ajayre/djetecutester/InjectorStand/InjectorStand2.png

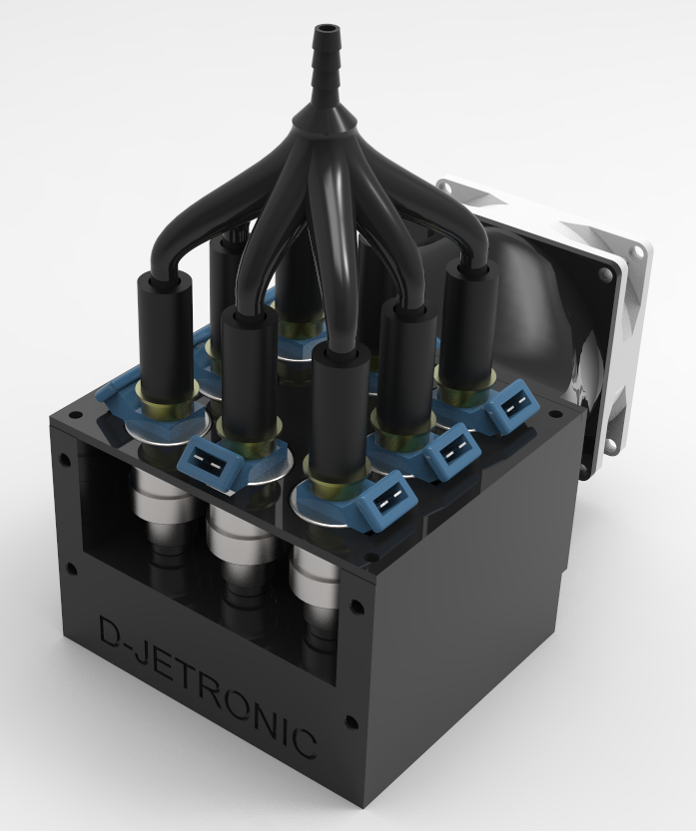
InjectorStand/InjectorStand2.png
