ajayre/djetecutester/InjectorStand/InjectorStand.png

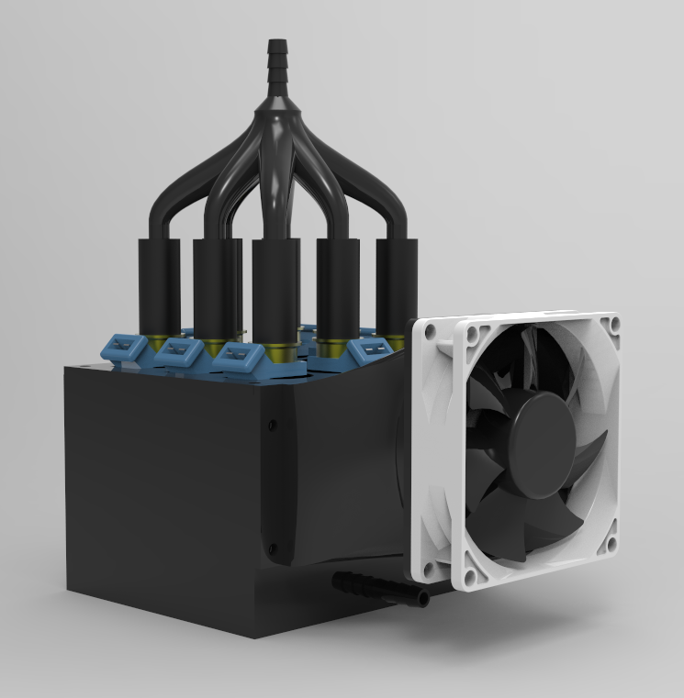
InjectorStand/InjectorStand.png
