ajayre/djetecutester/README.md

# D-Jetronic ECU Tester

A board for testing D-Jetronic ECUs installed on Mercedes C/R107 vehicles.

No warranty, express or implied. Use at your own risk.
