ajayre/djetecutester/DJet ECU Tester/Temperature/Schematics/AirTemp.png

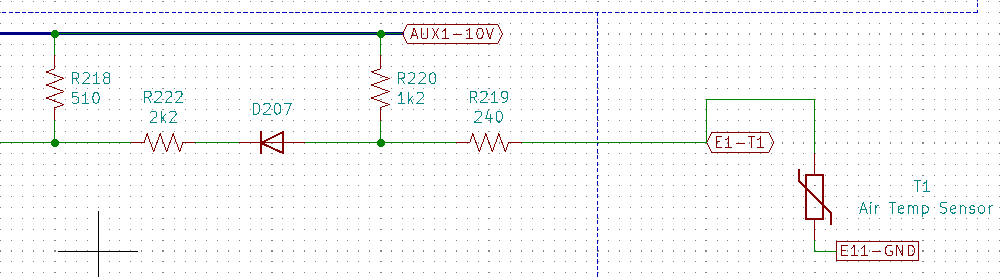
DJet ECU Tester/Temperature/Schematics/AirTemp.png
