ajayre/djetecutester/DJet ECU Tester/TPS/Schematics/TPS-AccelAdvance.png

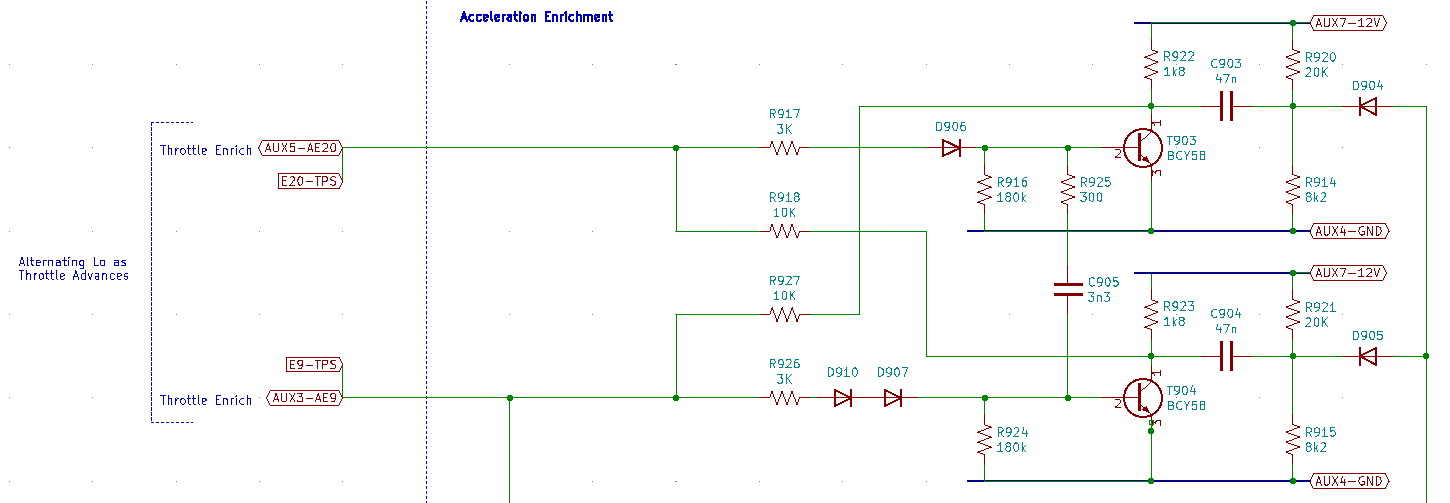
DJet ECU Tester/TPS/Schematics/TPS-AccelAdvance.png
