ajayre/djetecutester/DJet ECU Tester/TPS/Schematics/TPS-FullThrottle.png

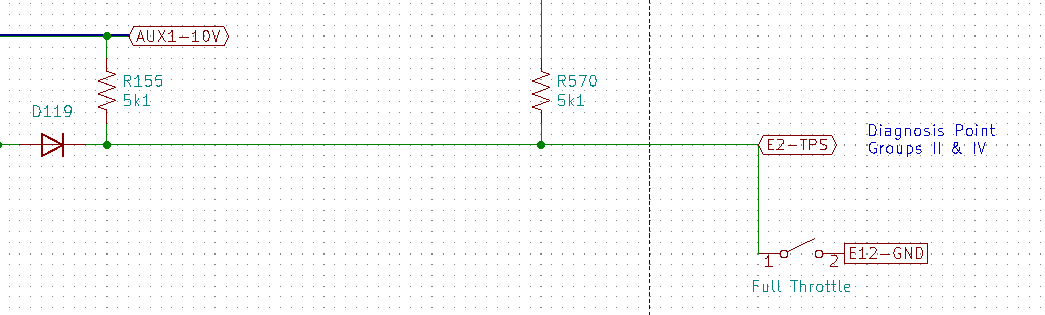
DJet ECU Tester/TPS/Schematics/TPS-FullThrottle.png
