ajayre/djetecutester/InjectorStand/Fan/Fan_Assembly.STEP

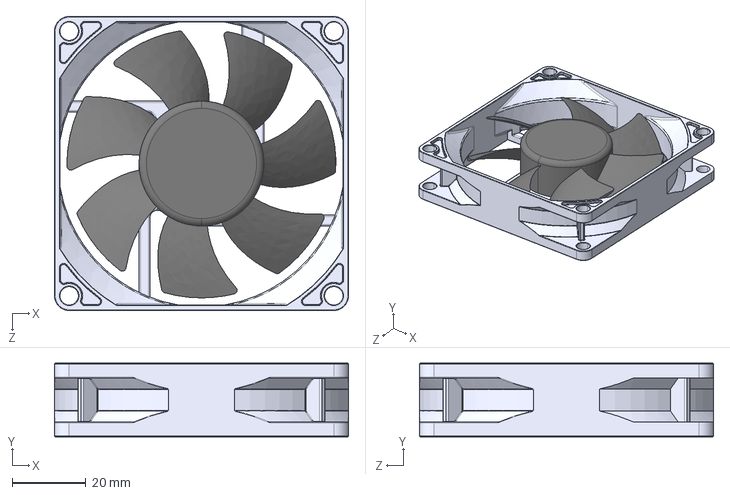
[picture p7: CAD file, 2021-06-29]
InjectorStand/Fan/Fan_Assembly.STEP
80.0 x 20.0 x 80.0 mm
Fan_Case
Fan
