ajayre/djetecutester/DJet ECU Tester/PCB/DJetECUTester/Base/Base.stl

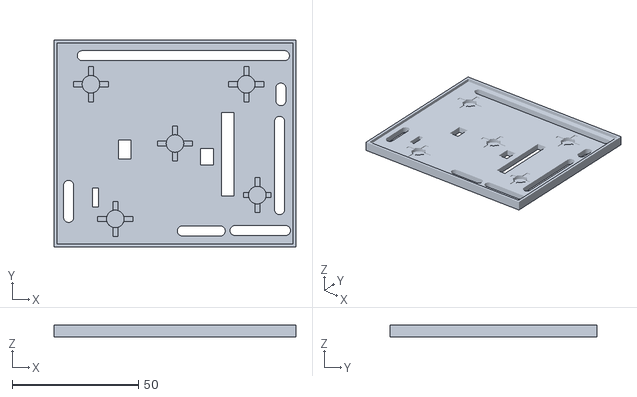
[picture p8: CAD file, 2021-04-21]
DJet ECU Tester/PCB/DJetECUTester/Base/Base.stl
96.0 x 82.0 x 4.60
