ajayre/djetecutester/InjectorStand/Lid.stl

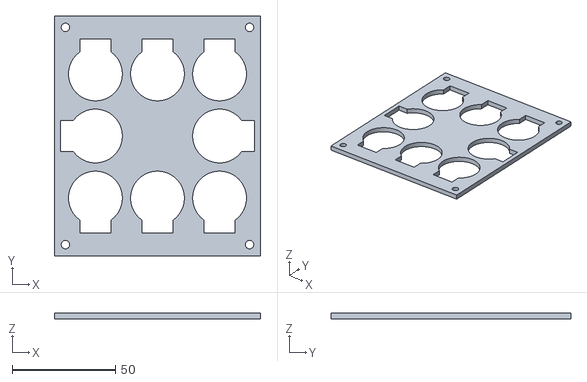
[picture p9: CAD file, 2021-06-29]
InjectorStand/Lid.stl
99.6 x 116.0 x 3.00
