ajayre/djetecutester/InjectorStand/TubSupport.stl

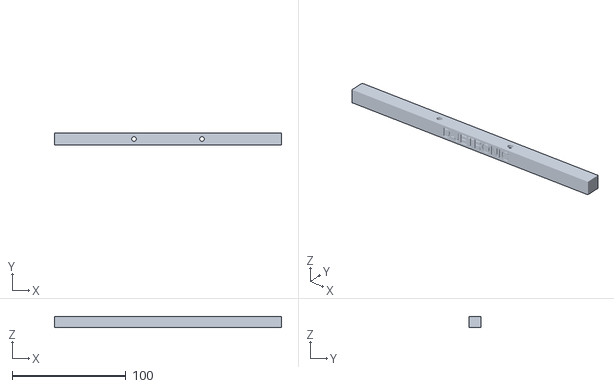
[picture p10: CAD file, 2021-06-29]
InjectorStand/TubSupport.stl
200.0 x 11.0 x 10.0
