ajayre/djetecutester/InjectorStand/CoolantCollector.stp

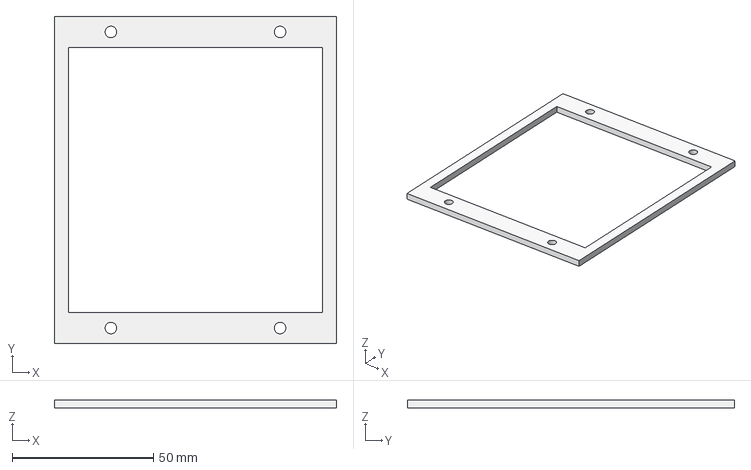
[picture p11: CAD file, 2021-06-29]
InjectorStand/CoolantCollector.stp
100.0 x 116.0 x 3.00 mm
