ajayre/djetecutester/InjectorStand/Funnel.stp

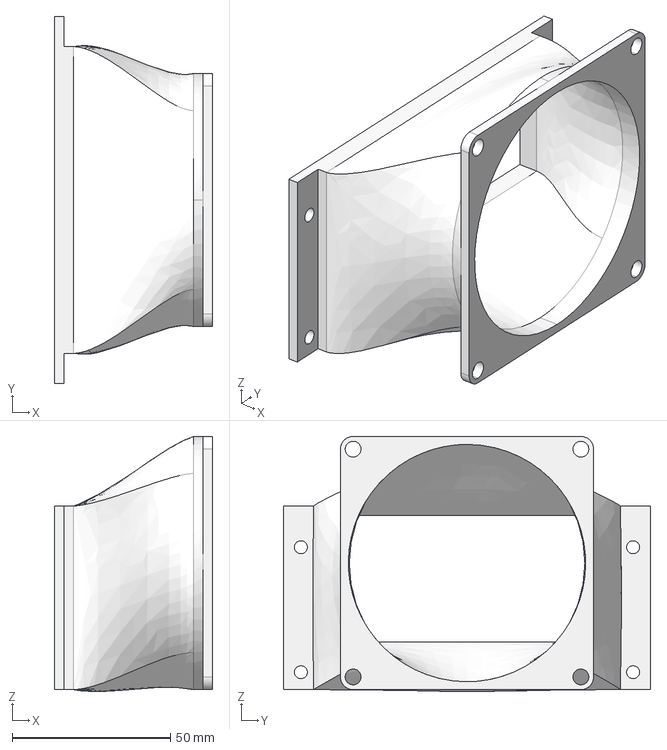
[picture p12: CAD file, 2021-06-29]
InjectorStand/Funnel.stp
50.0 x 116.0 x 80.6 mm
