ajayre/djetecutester/InjectorStand/Stand.stl

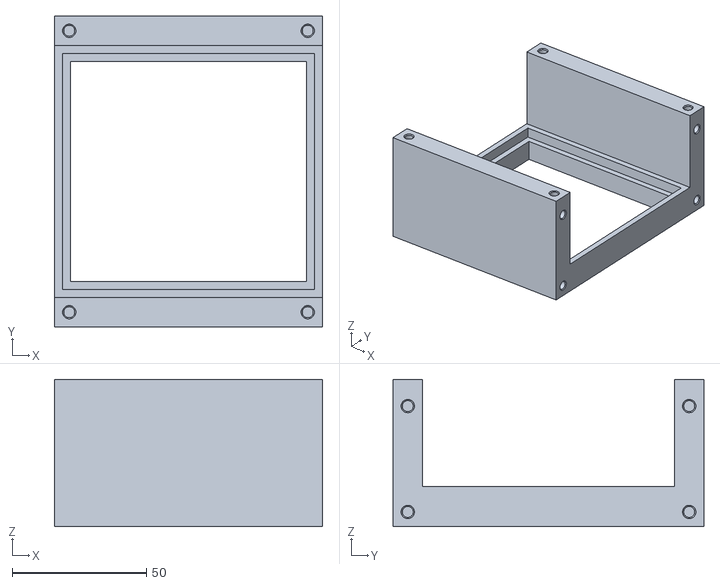
[picture p13: CAD file, 2021-06-29]
InjectorStand/Stand.stl
100.0 x 116.0 x 55.0
