ajayre/djetecutester/InjectorStand/CoolantFeederBarbed.stl

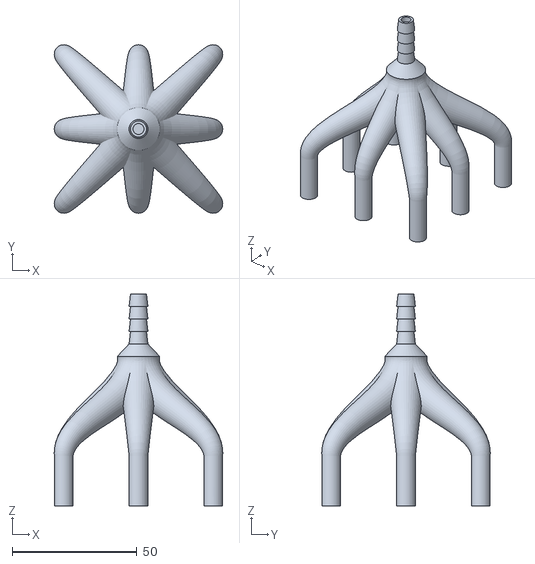
[picture p14: CAD file, 2021-06-29]
InjectorStand/CoolantFeederBarbed.stl
67.6 x 67.6 x 85.0
