ajayre/djetecutester/InjectorStand/StandInsert.stl

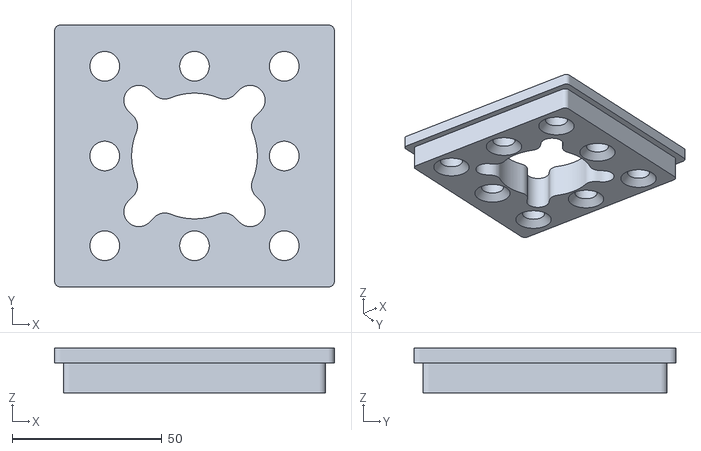
[picture p15: CAD file, 2021-06-29]
InjectorStand/StandInsert.stl
93.6 x 87.6 x 15.0
