ajayre/djetecutester/InjectorStand/CoolantFeeder.stl

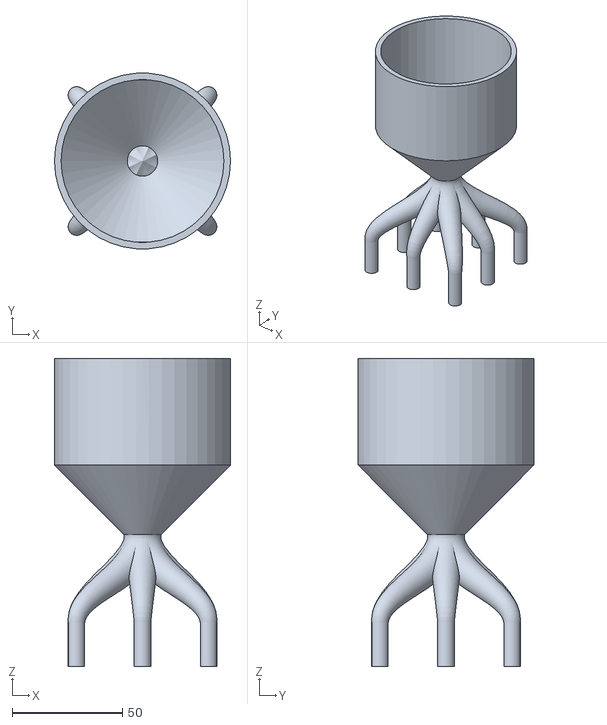
[picture p16: CAD file, 2021-06-29]
InjectorStand/CoolantFeeder.stl
80.0 x 80.0 x 140.0
