ajayre/djetecutester/(list of files, cad)

Other CAD files:
InjectorStand/CoolantCollector.3dm
InjectorStand/CoolantCollector.stl
InjectorStand/CoolantFeeder.3dm
InjectorStand/CoolantFeederBarbed.3dm
InjectorStand/Funnel.3dm
InjectorStand/Funnel.stl
