ajayre/djetecutester/DJet ECU Tester/Temperature/Steinhart-Hart Calculator for T1 Air Temp Sensor.xlsx

 | www.meas-spec.com
FINDING RESISTANCE AND TEMPERATURE USING STEINHART & HART EQUATION
 |  |  | 1/T = a + b(Ln R) + c(Ln R)^3, T in degrees Kelvin
Serial No.: | 0 280 130 006
Fill in temperatures and resistance for basis of calculating a,b,and c.
 | Temp °C | Resistance Ω | Temp °K | LnR
Low | 0 | 640 | 273.15 | 6.4614682 |  | Thermistor Calculator
Mid | 20 | 300 | 293.15 | 5.7037825
High | 40 | 150 | 313.15 | 5.0106353
Ln(R1) - Ln(R2) | 0.75768570
Ln(R1) - Ln(R3) | 1.45083288
(1/T1) - (1/T2) | 0.00024977
(1/T1) - (1/T3) | 0.00046763
Coefficients
a= | 0.001806885
b= | 0.000261256
c= | 0.000000615
Solving for R, given T: |  | Resistance Ω | dR/dT | %dR/dT | alpha | beta
Degrees °C= | 28 | 225.69 | -7.89 | -3.50 | -2459.85482 | 2084.92426
Temp °K= | 301.15
Solving For T, given R:
Ohms= | 253.9 | Temp °C= | 24.65 | Temp °F= | 76.38
To find resistance -
 | Degree °C | Resistance Ω | DRDT | alpha | beta | Degree °F
Enter Temp: | -10.00 | 959.83 | -39.79493419 | -3239.077227 | 2336.042179 | 14
 | 0.00 | 640.00 | -25.35327398 | -3012.998604 | 2259.143176 | 32
 | 10.00 | 434.47 | -16.45303008 | -2802.888805 | 2190.487196 | 50
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
