ajayre/djetecutester/DJet ECU Tester/Simulation/Injector Drivers/CurrentConsumption.png

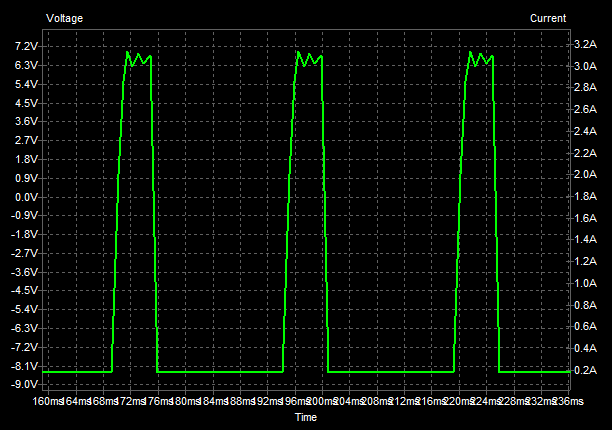
DJet ECU Tester/Simulation/Injector Drivers/CurrentConsumption.png
