ajayre/djetecutester/DJet ECU Tester/Simulation/Injector Drivers/InjCurrentConsumption.png

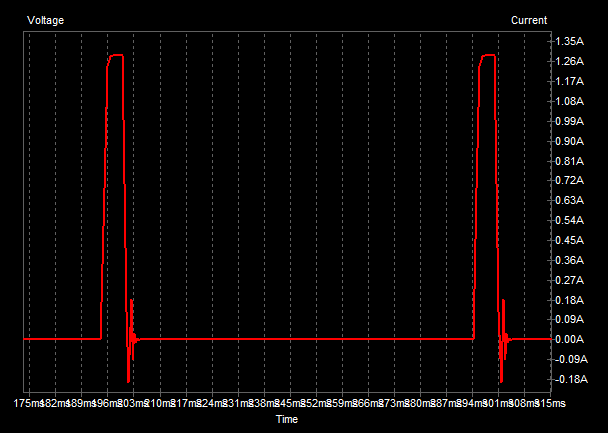
DJet ECU Tester/Simulation/Injector Drivers/InjCurrentConsumption.png
