ajayre/djetecutester/DJet ECU Tester/Simulation/Injector Drivers/InjectorModel.png

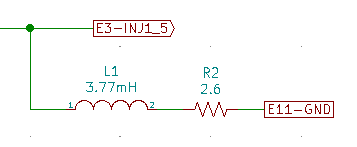
DJet ECU Tester/Simulation/Injector Drivers/InjectorModel.png
