ajayre/djetecutester/DJet ECU Tester/Simulation/Injector Drivers/InjectorWaveform.png

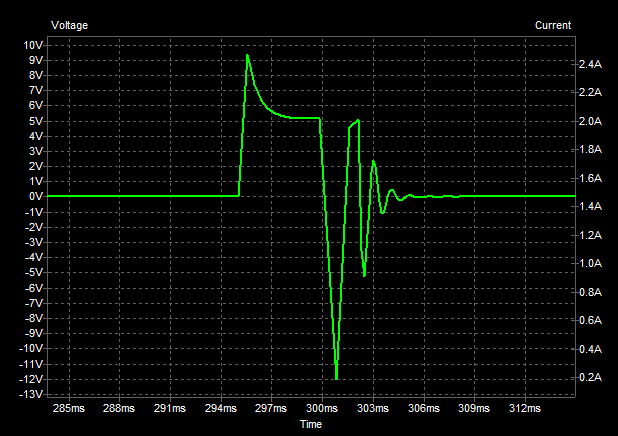
DJet ECU Tester/Simulation/Injector Drivers/InjectorWaveform.png
