ajayre/djetecutester/(commit log)

2021-03-06 Started work on an ECU tester.
    [DJetECUTester.kicad_pcb, DJetECUTester.sch, TPS.sch, Temperature.sch, Triggering.sch, USBandPower.sch, Vacuum.sch]
2021-03-06 Added injector waveform test points.
    [DJetECUTester.sch, Triggering.sch]
2021-03-09 Working on ECU tester and ECU outputs board.
    [CSV.sch, DJetECUTester.sch, ECUOutputs.kicad_pcb, ECUOutputs.sch, TPS.sch, Temperature.sch, Triggering.sch, USBandPower.sch]
2021-03-09 Started work on PCB.
    [Temperature.sch]
2021-03-10 Working on PCB layout. Changed CSV circuit from optocoupler to transistors. Added decoupling caps for digital pots.
    [CSV.sch, DJetECUTester.kicad_pcb, DJetECUTester.sch, TPS.sch, Temperature.sch, Triggering.sch, USBandPower.sch, Vacuum.sch]
2021-03-10 Corrected mistake in flip-flop copied from 005 ECU schematic.
    [ECUOutputs.sch, TPS.sch, Triggering.sch]
2021-03-12 Working on PCB layout
    [DJetECUTester.kicad_pcb, DJetECUTester.sch, Vacuum.sch]
2021-03-12 Adding 3D models.
    [DJetECUTester.kicad_pcb, USBandPower.sch]
2021-03-12 Added final 3D models.
    [CSV.sch, DJetECUTester.kicad_pcb, DJetECUTester.sch, TPS.sch, Temperature.sch, Triggering.sch, USBandPower.sch, Vacuum.sch]
2021-03-14 Added simulation of injector drivers - only 1-5 group tested.
    [DJetECUTester.kicad_pcb, DJetECUTester.sch, InjectorDrivers.kicad_pcb, InjectorDrivers.sch]
2021-03-14 Updated injector driver simulation to make measuring current consumption easier.
    [InjectorDrivers.sch]
2021-03-14 Increased injectors from four to eight. Added current measurement for injector groups.
    [InjectorDrivers.sch]
2021-03-15 Added connector for injector groups.
    [DJetECUTester.kicad_pcb, DJetECUTester.sch]
2021-03-15 Updated manufacturer part numbers. Working on ECU outputs tester board.
    [DJetECUTester.sch, ECUOutputs.kicad_pcb, ECUOutputs.sch, TPS.sch, Temperature.sch, Triggering.sch, USBandPower.sch, Vacuum.sch]
2021-03-16 Added resistor to tester. Generated manufacturing files.
    [CSV.sch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]
2021-03-16 Laid out ECU outputs PCB. Generated manufacturing files.
    [ECUOutputs-B_Cu.gbr, ECUOutputs-B_Mask.gbr, ECUOutputs-B_Paste.gbr, ECUOutputs-B_SilkS.gbr, ECUOutputs-Edge_Cuts.gbr, ECUOutputs-F_Cu.gbr, ECUOutputs-F_Mask.gbr, ECUOutputs-F_Paste.gbr]
2021-03-20 Removed cold start valve - this appears to be an output from the ECU so we can't control it.
2021-03-21 Renamed CSV to Start. Added PDF version of schematics.
    [DJetECUTester.sch, Start.sch, TPS.sch, Temperature.sch, Triggering.sch, USBandPower.sch, Vacuum.sch]
2021-03-22 Added Steinhart-Hart models for temperature sensors. Adapted from Brad's spreadsheets.
2021-03-23 Added library to control timer 1.
2021-03-24 Added spreadsheets for thermistor models from Brad Cushman.
    [Steinhart-Hart Calculator for T1 Air Temp Sensor.xlsx, Steinhart-Hart Calculator for T2 Coolant Temp Sensor.xlsx]
2021-03-25 Fixed bugs. Changed angle to dwell.
    [Engine.cpp, Menu.cpp]
2021-03-28 Added jig for installing pin headers.
    [PinHeaderJig.stl]
2021-04-04 Updated temperature support - untested. Switched to Arduino "new" bootloader.
    [InjectorDrivers.sch]
2021-04-05 Worked around mistake in schematic that swapped trigger groups 2 and 3.
    [Engine.cpp]
2021-04-07 Working on version 1.1
    [DJetECUTester.kicad_pcb, DJetECUTester.sch, Start.sch, TPS.sch, Temperature.sch, Triggering.sch, USBandPower.sch, Vacuum.sch]
2021-04-08 Completed first attempt at new layout.
    [DJetECUTester.kicad_pcb]
2021-04-08 Added D-Jetronic text and stiching vias.
    [DJetECUTester.kicad_pcb]
2021-04-09 Updated manufacturing files.
    [DJetECUTester-B_Cu.gbr, DJetECUTester-B_Mask.gbr, DJetECUTester-B_Paste.gbr, DJetECUTester-B_SilkS.gbr, DJetECUTester-Edge_Cuts.gbr, DJetECUTester-F_Cu.gbr, DJetECUTester-F_Mask.gbr, DJetECUTester-F_Paste.gbr]
2021-04-21 Updated 3D model. Added 3D printed Base. LED now flashes faster when engine is running.
    [Base.stl, PinHeaderJig.stl]
2021-04-21 Updated Schematic Removed gcode file.
2021-06-06 Improved TPS implementation to generate all of the enrichment pulses when increasing throttle. Always goes back to default throttle enrichment settings for zero throttle. No longer asks for up or dow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
    [Engine.cpp, Menu.cpp]
2021-06-29 Rewrote pulse generator to fix bugs with duty cycle.
    [Engine.cpp, Menu.cpp]
2021-06-29 Created V3 release. Added 3D files.
    [CoolantCollector.3dm, CoolantCollector.stl, CoolantCollector.stp, CoolantFeeder.3dm, CoolantFeeder.stl, CoolantFeederBarbed.3dm, CoolantFeederBarbed.stl, Fan_Assembly.STEP]
2021-07-12 Inverted operation of pulse generator waveforms.
    [Engine.cpp, Menu.cpp]
2021-07-13 Reverted back to r56. The debug output added for r57 was not needed.
    [Engine.cpp, Menu.cpp]
2021-07-13 Set minimum PG dwell to 39 degrees. This corresponds to a 1ms pulse at 6,500 RPM.
2021-07-23 Added start of CloneECU project.
    [Aux Board 1.sch, Aux Board 2.sch, CloneECU.sch, MPS & Temp Sensors.sch, Pulse Generator & Injectors.sch, TPS & Fuel Pump.sch]
2021-07-23 Removed components external to the ECU. Changed text blocks. Passes the electrical DRC.
    [Aux Board 1.sch, Aux Board 2.sch, CloneECU.sch, MPS & Temp Sensors.sch, Pulse Generator & Injectors.sch, TPS & Fuel Pump.sch]
2021-07-25 Moved CloneECU to it's own repo.
    [Aux Board 1.sch, Aux Board 2.sch, CloneECU.sch, MPS & Temp Sensors.sch, Pulse Generator & Injectors.sch, TPS & Fuel Pump.sch]
2021-07-25 Removed old project.
    [ECUOutputs-B_Cu.gbr, ECUOutputs-B_Mask.gbr, ECUOutputs-B_Paste.gbr, ECUOutputs-B_SilkS.gbr, ECUOutputs-Edge_Cuts.gbr, ECUOutputs-F_Cu.gbr, ECUOutputs-F_Mask.gbr, ECUOutputs-F_Paste.gbr]
2021-08-01 Added more current measurements to injector driver simulation.
    [InjectorDrivers.sch]
2022-08-02 Updated ECU connector drawing and added color to 3D model.
2022-09-22 Updated to use new TPS throttle % settings.
